liwq4ever/vin-restore/manufacturing/VIN_FRAME_V2_MAGNETIC/02_cad/assembly_nominal.step

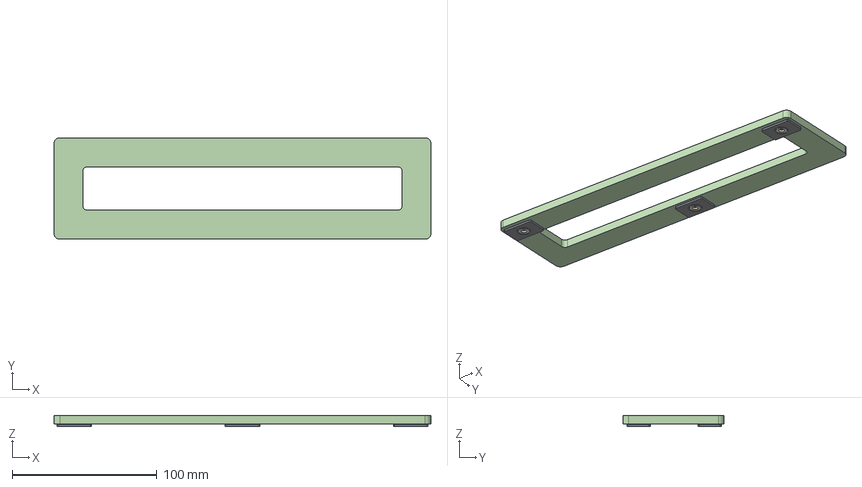
[picture p2: CAD file, 2026-10-10]
manufacturing/VIN_FRAME_V2_MAGNETIC/02_cad/assembly_nominal.step
260.0 x 70.0 x 7.70 mm
G10_CNC_body
PEEK_pad_1 x 3
bond_layer_1 x 3
magnetic_tile_1 x 3
