liwq4ever/vin-restore/manufacturing/VIN_FRAME_V2_MAGNETIC/02_cad/g10_frame_operations.dxf

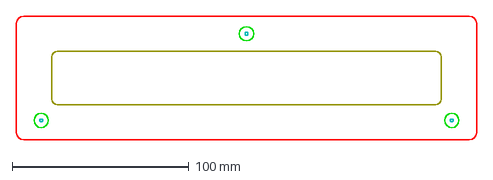
[picture p3: CAD file, 2026-10-10]
manufacturing/VIN_FRAME_V2_MAGNETIC/02_cad/g10_frame_operations.dxf
260.0 x 70.0 mm
