liwq4ever/vin-restore/manufacturing/VIN_FRAME_V2_MAGNETIC/03_artwork/black_pattern_filled.dxf

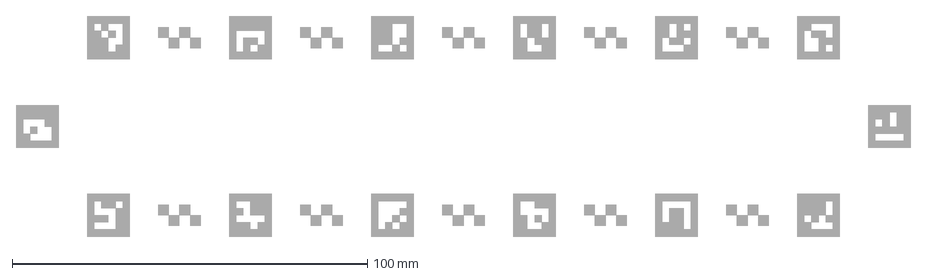
[picture p4: CAD file, 2026-10-10]
manufacturing/VIN_FRAME_V2_MAGNETIC/03_artwork/black_pattern_filled.dxf
252.0 x 62.0 mm
