liwq4ever/vin-restore/manufacturing/VIN_FRAME_V2_MAGNETIC/02_cad/rough_cut_profile_only.dxf

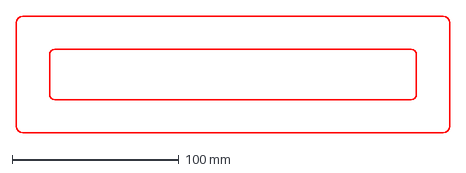
[picture p5: CAD file, 2026-10-10]
manufacturing/VIN_FRAME_V2_MAGNETIC/02_cad/rough_cut_profile_only.dxf
260.0 x 70.0 mm
