liwq4ever/vin-restore/manufacturing/VIN_FRAME_V2_MAGNETIC/02_cad/peek_contact_pad.step

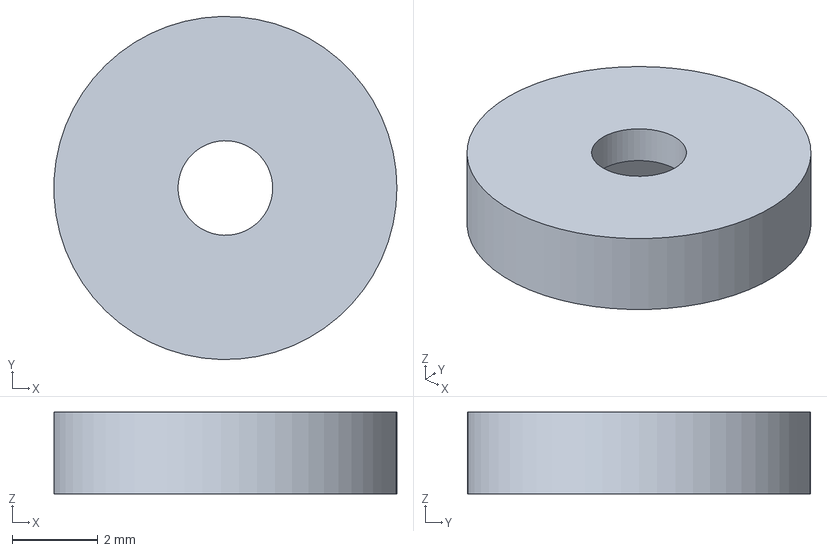
[picture p6: CAD file, 2026-10-10]
manufacturing/VIN_FRAME_V2_MAGNETIC/02_cad/peek_contact_pad.step
7.97 x 7.98 x 1.90 mm
