liwq4ever/vin-restore/manufacturing/VIN_FRAME_V2_MAGNETIC/02_cad/magnetic_tile.step

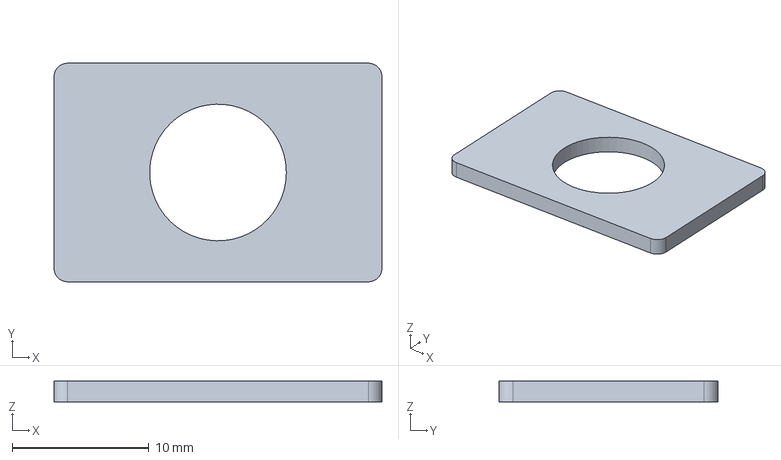
[picture p8: CAD file, 2026-10-10]
manufacturing/VIN_FRAME_V2_MAGNETIC/02_cad/magnetic_tile.step
24.0 x 16.0 x 1.50 mm
