liwq4ever/vin-restore/manufacturing/VIN_FRAME_V2_MAGNETIC/02_cad/magnetic_tile_cut_1to1.dxf

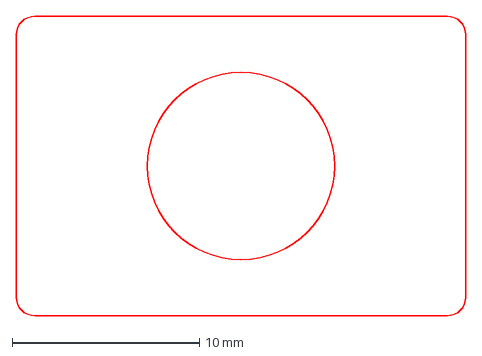
[picture p9: CAD file, 2026-10-10]
manufacturing/VIN_FRAME_V2_MAGNETIC/02_cad/magnetic_tile_cut_1to1.dxf
24.0 x 16.0 mm
