liwq4ever/vin-restore/manufacturing/VIN_FRAME_V2_MAGNETIC/02_cad/back_layout_front_xy_not_mirrored.dxf

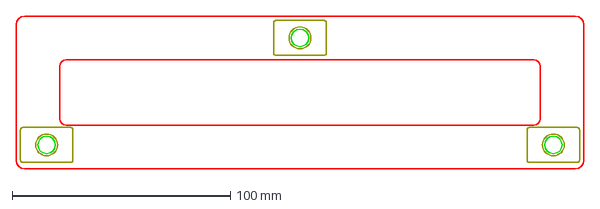
[picture p10: CAD file, 2026-10-10]
manufacturing/VIN_FRAME_V2_MAGNETIC/02_cad/back_layout_front_xy_not_mirrored.dxf
260.0 x 70.0 mm
