liwq4ever/vin-restore/manufacturing/VIN_FRAME_V2_MAGNETIC/02_cad/bond_layer_nominal.step

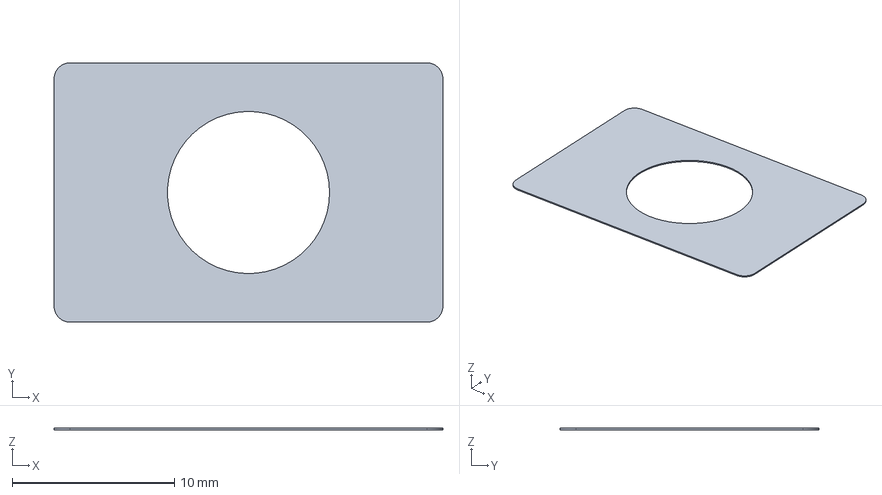
[picture p11: CAD file, 2026-10-10]
manufacturing/VIN_FRAME_V2_MAGNETIC/02_cad/bond_layer_nominal.step
24.0 x 16.0 x 0.1 mm
