liwq4ever/vin-restore/manufacturing/VIN_FRAME_V2_MAGNETIC/README.md

# VIN参考框 V2 磁吸版

采用6毫米G10玻纤环氧主体、三片柔性钕铁硼磁贴及三点PEEK硬定位垫，中央开窗露出钢印。

先读《制作与验收说明》，再看4页A3加工图。此版本是首件加工评审包，未通过实体吸力、磁吸形变或系统0.2毫米验收。不可把软磁片直接作为尺寸基准。

- `01_drawings/`：加工PDF和结构预览。
- `02_cad/`：主体、垫、磁贴及名义胶层STEP；装配STEP；主体/磁贴下料DXF；背面定位DXF。
- `03_artwork/`：毫米尺寸SVG、填充DXF、1:1 PDF、位图。
- `04_calibration/`：设计坐标、磁吸状态实测模板、实体验收模板。
- `06_sources/`：可再生成文件的脚本、说明原文、依赖和嵌入字体。

磁吸框采用三个硬接触点，标记面名义高度7.70毫米加涂层；正式使用必须加载序列号对应的实测校准档案。

复现：在06_sources中安装requirements.txt，运行 `python build_package.py`；如修改中文文本，先运行 `python embed_font.py`（需要系统Noto Sans CJK字体）。
