liwq4ever/vin-restore/manufacturing/VIN_FRAME_V2_MAGNETIC/03_artwork/pattern_1524ppi.png

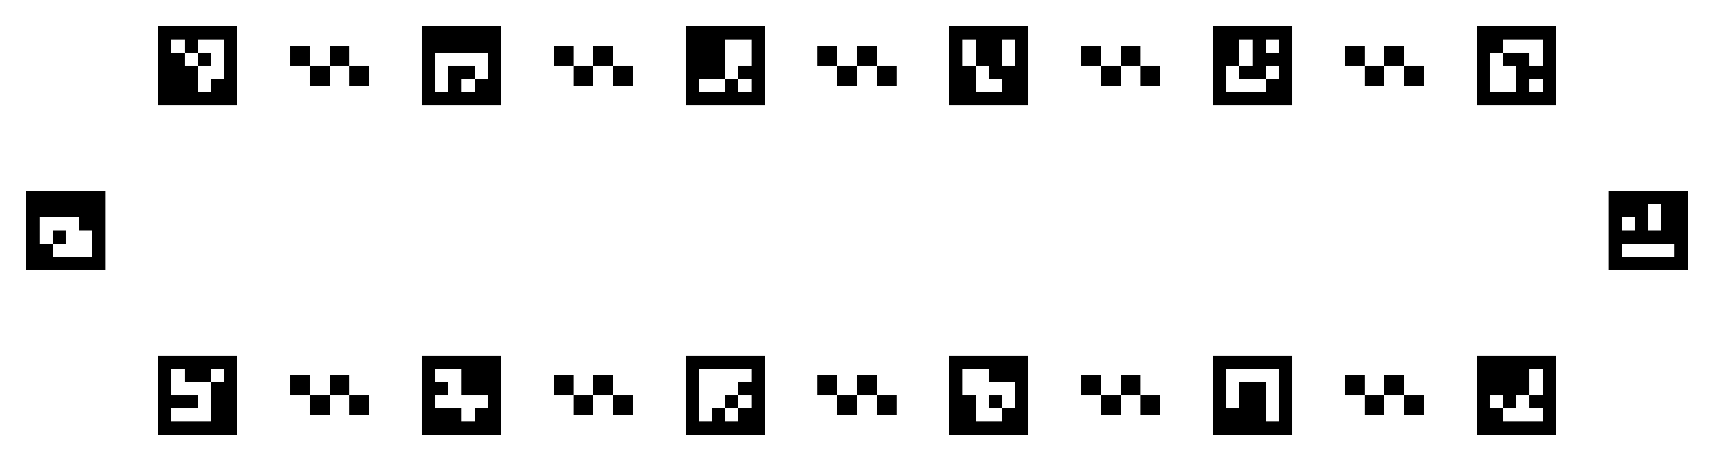
manufacturing/VIN_FRAME_V2_MAGNETIC/03_artwork/pattern_1524ppi.png
