liwq4ever/vin-restore/manufacturing/VIN_FRAME_V2_MAGNETIC/04_calibration/as_built_measurement_template.csv

feature_id | nominal_x_mm | nominal_y_mm | nominal_z_mm | loaded_measured_x_mm | loaded_measured_y_mm | loaded_measured_z_mm | expanded_uncertainty_mm | temperature_C | frame_serial | steel_fixture | instrument | operator | date
A00_TL | 24 | 66.0 | 7.7
A00_TR | 36 | 66.0 | 7.7
A00_BR | 36 | 54.0 | 7.7
A00_BL | 24 | 54.0 | 7.7
A01_TL | 64 | 66.0 | 7.7
A01_TR | 76 | 66.0 | 7.7
A01_BR | 76 | 54.0 | 7.7
A01_BL | 64 | 54.0 | 7.7
A02_TL | 104 | 66.0 | 7.7
A02_TR | 116 | 66.0 | 7.7
A02_BR | 116 | 54.0 | 7.7
A02_BL | 104 | 54.0 | 7.7
A03_TL | 144 | 66.0 | 7.7
A03_TR | 156 | 66.0 | 7.7
A03_BR | 156 | 54.0 | 7.7
A03_BL | 144 | 54.0 | 7.7
A04_TL | 184 | 66.0 | 7.7
A04_TR | 196 | 66.0 | 7.7
A04_BR | 196 | 54.0 | 7.7
A04_BL | 184 | 54.0 | 7.7
A05_TL | 224 | 66.0 | 7.7
A05_TR | 236 | 66.0 | 7.7
A05_BR | 236 | 54.0 | 7.7
A05_BL | 224 | 54.0 | 7.7
A06_TL | 24 | 16.0 | 7.7
A06_TR | 36 | 16.0 | 7.7
A06_BR | 36 | 4.0 | 7.7
A06_BL | 24 | 4.0 | 7.7
A07_TL | 64 | 16.0 | 7.7
A07_TR | 76 | 16.0 | 7.7
A07_BR | 76 | 4.0 | 7.7
A07_BL | 64 | 4.0 | 7.7
A08_TL | 104 | 16.0 | 7.7
A08_TR | 116 | 16.0 | 7.7
A08_BR | 116 | 4.0 | 7.7
A08_BL | 104 | 4.0 | 7.7
A09_TL | 144 | 16.0 | 7.7
A09_TR | 156 | 16.0 | 7.7
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
