liwq4ever/vin-restore/(commit log)

2026-10-10 Initialize VIN reference frame manufacturing repository
2026-10-10 Add VIN reference frame V1 drawings, CAD, artwork and manufacturing package
    [as_built_measurement_template.csv, assembly_nominal.step, black_pattern_filled.dxf, frame_parametric.scad, handle.step, handle.stl, metal_frame.step, metal_frame_operations.dxf]
2026-10-10 Add G10 magnetic VIN reference frame V2 manufacturing package
    [as_built_measurement_template.csv, assembly_nominal.step, back_layout_front_xy_not_mirrored.dxf, black_pattern_filled.dxf, bond_layer_nominal.step, g10_frame.step, g10_frame_operations.dxf, handle.step]
2026-10-10 Keep only magnetic frame design and remove auxiliary grips
    [as_built_measurement_template.csv, assembly_nominal.step, back_layout_front_xy_not_mirrored.dxf, black_pattern_filled.dxf, bond_layer_nominal.step, frame_parametric.scad, g10_frame.step, g10_frame_operations.dxf]
